JasonC0x0D/Hackster_Crew_2020_Public/Photos/Nozzle_Assembly.png

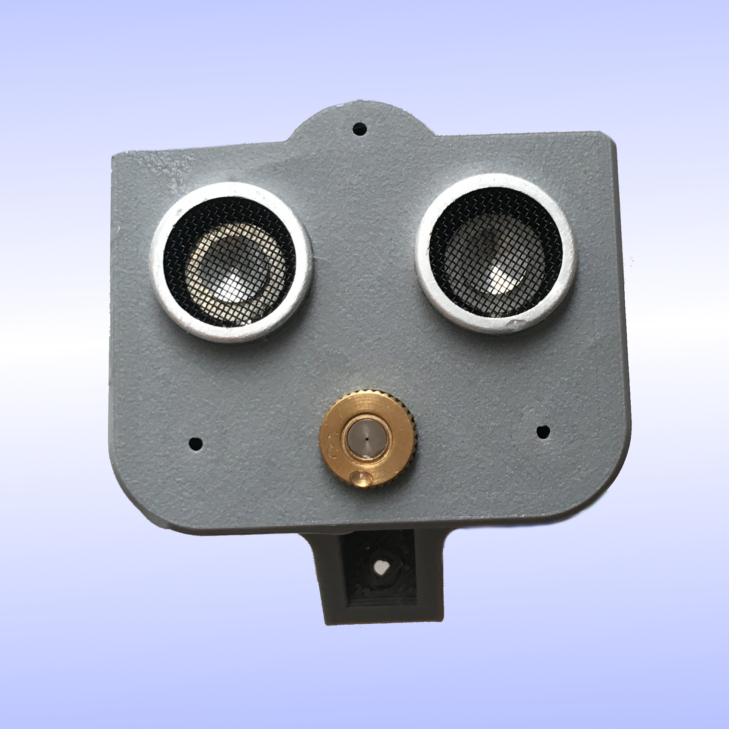
Photos/Nozzle_Assembly.png
