JasonC0x0D/Hackster_Crew_2020_Public/Photos/Assembly_isometric_front_gradient.png

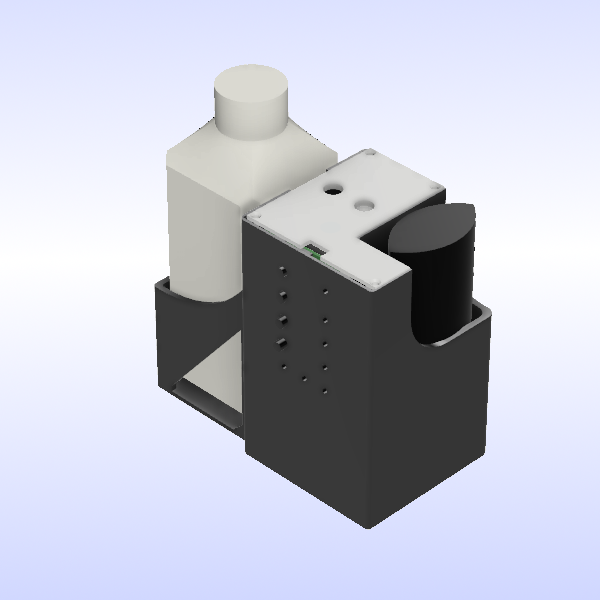
Photos/Assembly_isometric_front_gradient.png
