JasonC0x0D/Hackster_Crew_2020_Public/README.md

# Hackster_Crew_2020

Authors:
Chris Born
Forrest Carlson
Jason Cowin
Jordan Stanton
Blake Wiley

Project At:
https://www.hackster.io/hackster-crew-2020/sanitizer-2020-5bf8f2
