JasonC0x0D/Hackster_Crew_2020_Public/Photos/Features_gradient.png

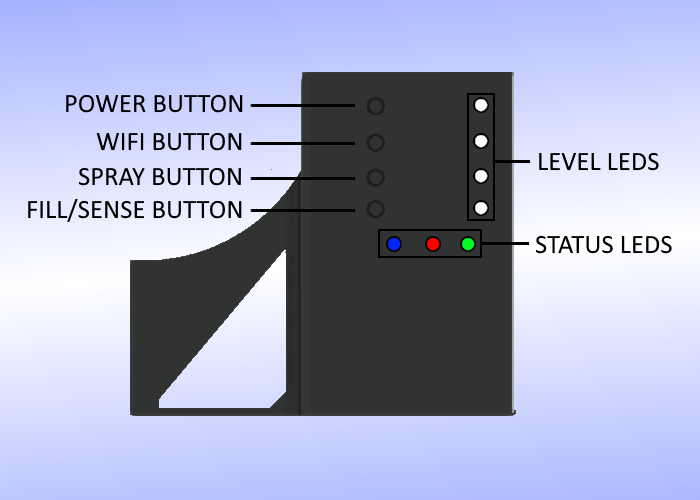
Photos/Features_gradient.png
