JasonC0x0D/Hackster_Crew_2020_Public/Photos/Features_no_background.png

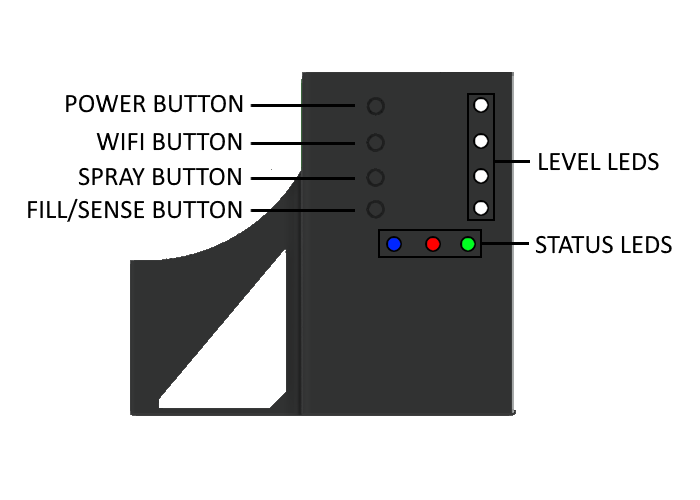
Photos/Features_no_background.png
