JasonC0x0D/Hackster_Crew_2020_Public/Photos/PCB_rendering.png

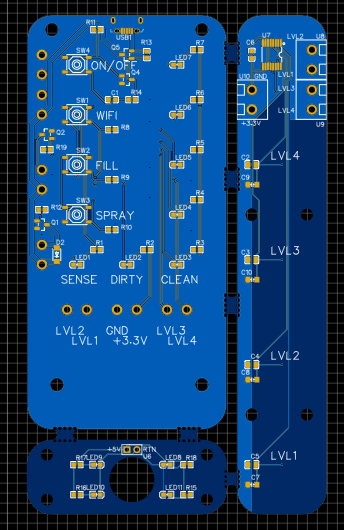
Photos/PCB_rendering.png
