JasonC0x0D/Hackster_Crew_2020_Public/Photos/Use_All.jpg

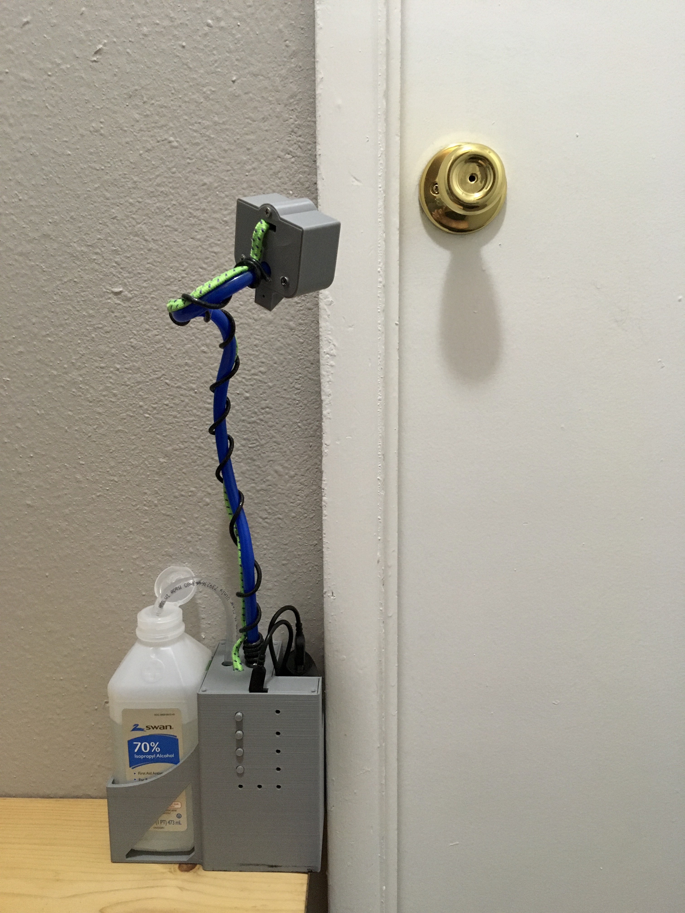
Photos/Use_All.jpg
