JasonC0x0D/Hackster_Crew_2020_Public/Photos/Use_Close_Up.jpg

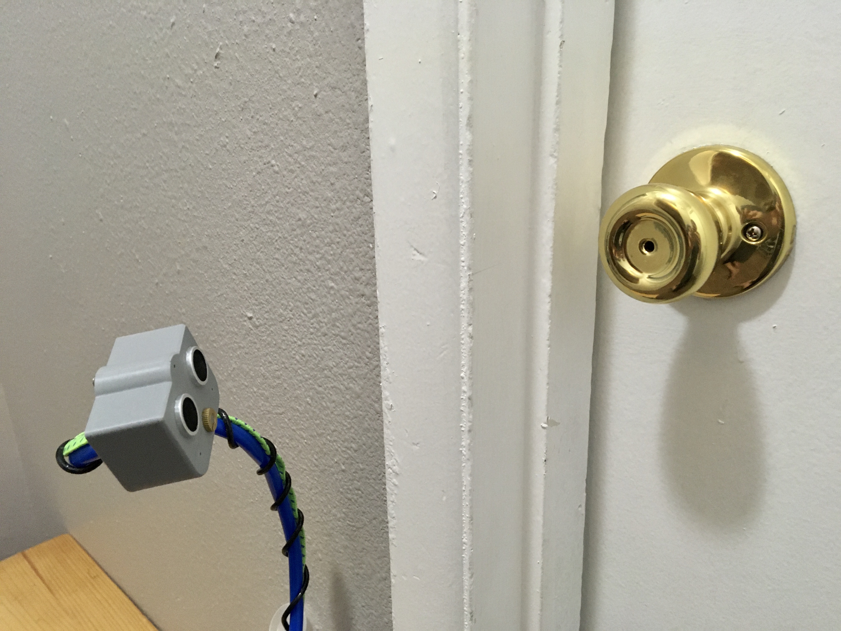
Photos/Use_Close_Up.jpg
