JasonC0x0D/Hackster_Crew_2020_Public/Schematics/State_Machine_Buttons.png

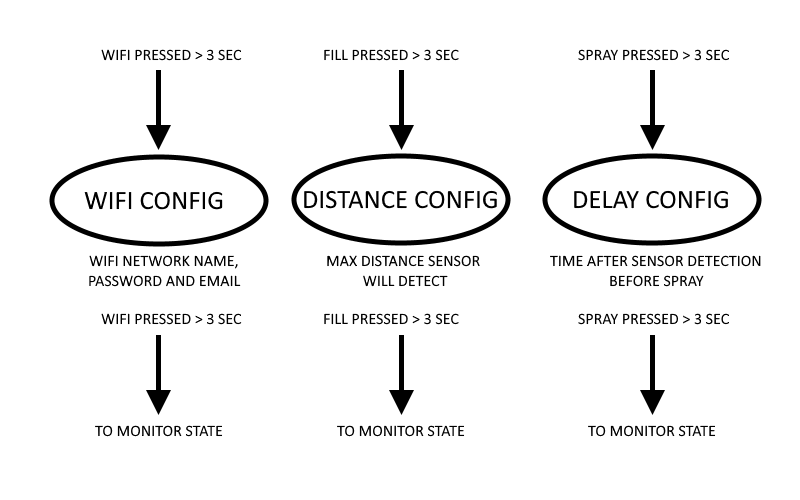
Schematics/State_Machine_Buttons.png
