JasonC0x0D/Hackster_Crew_2020_Public/Parts/BOM_Sterilizer 2020_2020-06-25_02-06-41.csv

ID | Name | Designator | Footprint | Quantity | Manufacturer Part | Manufacturer | Supplier | Supplier Part | LCSC Assembly
1 | 22pF | C2 | C0805 | 1 | CL21C220JBANNNC | SAMSUNG | LCSC | C1804 | Yes
2 | 100K | R14 | R0603 | 1 | 0603WAF1003T5E | UniOhm | LCSC | C25803 | Yes
3 | 6pF | C5 | C0805 | 1 | 0805CG6R0C500N | FH | LCSC | C67560 | Yes
4 | 33pF | C3 | C0805 | 1 | CL21C330JBANNNC | SAMSUNG | LCSC | C1814 | Yes
5 | PWR_ON/OFF_P_FET | Q5 | SOT-23_L2.9-W1.3-P0.95-LS2.4-BR | 1 | AO3401A | AOS | LCSC | C15127 | Yes
6 | DIRTY_RED | LED2 | LED0603-R-RD | 1 | 19-21/R7C-AN2Q1B/3T | Everlight Elec | LCSC | C40378 | Yes
7 | LEVEL_1_WHITE | LED4 | LED0603-R-RD | 1 | 19-21/R7C-AN2Q1B/3T | Everlight Elec | LCSC | C40378 | Yes
8 | LEVEL_2_WHITE | LED5 | LED0603-R-RD | 1 | 19-21/R7C-AN2Q1B/3T | Everlight Elec | LCSC | C40378 | Yes
9 | LEVEL_3_WHITE | LED6 | LED0603-R-RD | 1 | 19-21/R7C-AN2Q1B/3T | Everlight Elec | LCSC | C40378 | Yes
10 | LEVEL_4_WHITE | LED7 | LED0603-R-RD | 1 | 19-21/R7C-AN2Q1B/3T | Everlight Elec | LCSC | C40378 | Yes
11 | NOZ_1 | LED8,LED9,LED10,LED11 | LED0603-R-RD | 4 | 19-21/R7C-AN2Q1B/3T | Everlight Elec | LCSC | C40378 | Yes
12 | 100nF | C6 | C0603 | 1 | CC0603KRX7R9BB104 | YAGEO | LCSC | C14663 | Yes
13 | CLEAN_GREEN | LED3 | LED0603-R-RD | 1 | 19-217/GHC-YR1S2/3T | EVERLIGHT | LCSC | C72043 | Yes
14 | WIFI | SW1 | SW-SMD_4P-L5.1-W5.1-P3.70-LS6.4 | 1 | TS-1187A-B-A-B | XKB Enterprise | LCSC | C318884 | Yes
15 | FILL | SW2 | SW-SMD_4P-L5.1-W5.1-P3.70-LS6.4 | 1 | TS-1187A-B-A-B | XKB Enterprise | LCSC | C318884 | Yes
16 | SPRAY | SW3 | SW-SMD_4P-L5.1-W5.1-P3.70-LS6.4 | 1 | TS-1187A-B-A-B | XKB Enterprise | LCSC | C318884 | Yes
17 | PWR | SW4 | SW-SMD_4P-L5.1-W5.1-P3.70-LS6.4 | 1 | TS-1187A-B-A-B | XKB Enterprise | LCSC | C318884 | Yes
18 | Arduino_Nano_Every | U1 | ARDUINO_NANO_SMD | 1 | Arduino Nano V3
19 | 100 | R1,R3,R4,R5,R6,R7,R15,R16,R17,R18 | R0603 | 10 | 0603WAF1000T5E | UniOhm | LCSC | C22775 | Yes
20 | MICRO B | USB1 | MICRO-USB-SMD_10118194-0001LF | 1 | 10118194-0001LF | Amphenol ICC | LCSC | C132563
21 | 1uF | C1 | C0603 | 1 | CL10A105KB8NNNC | SAMSUNG | LCSC | C15849 | Yes
22 | SENSE_BLUE | LED1 | LED0603-R-RD | 1 | 19-217/BHC-ZL1M2RY/3T | EVERLIGHT | LCSC | C72041 | Yes
23 | PUMP | U2 | CONN-TH_2P-P5.00_L7.8-W10.0 | 1 | DB126V-5.0-2P | DIBO | LCSC | C395849
24 | SENSOR_2 | U3 | CONN-TH_2P-P5.00_L7.8-W10.0 | 1 | DB126V-5.0-2P | DIBO | LCSC | C395849
25 | SENSOR_1 | U4,U11,U12,U13,U8,U9,U10 | CONN-TH_2P-P5.00_L7.8-W10.0 | 7 | DB126V-5.0-2P | DIBO | LCSC | C395849
26 | MAIN_BOARD | U5 | CONN-TH_2P-P5.00_L7.8-W10.0 | 1 | DB126V-5.0-2P | DIBO | LCSC | C395849
27 | LED_RING | U6 | HDR-M-2.54_1X2 | 1 |  |  | LCSC | C124375
28 | 0 | C7,C8,C9,C10 | 0805-CAP-LARGEPADS | 4
29 | 10K | R13,R11,R12,R19 | R0603 | 4 | 0603WAF1002T5E | UniOhm | LCSC | C25804 | Yes
30 | 300 | R2,R8,R9,R10 | R0603 | 4 | 0603WAF3000T5E | UniOhm | LCSC | C23025 | Yes
31 | TTP224B-BSBN | U7 | TSSOP-16_L5.0-W4.4-P0.65-LS6.4-BL | 1 | TTP224B-BSBN | TONTEK | LCSC | C94149 | Yes
32 | 10pF | C4 | C0805 | 1 | CL21C100JBANNNC | SAMSUNG | LCSC | C1785 | Yes
33 | FLYBACK DIODE | D2 | SOD-123F_L2.8-W1.8-LS3.7-RD | 1 | SM4007PL | MDD | LCSC | C64898 | Yes
34 | PUMP_FET | Q1 | SOT-23-3_L2.9-W1.6-P1.90-LS2.8-BR | 1 | AO3400A | AOS | LCSC | C20917 | Yes
35 | PWR_ON/OFF_N_FET | Q4 | SOT-23-3_L2.9-W1.6-P1.90-LS2.8-BR | 1 | AO3400A | AOS | LCSC | C20917 | Yes
36 | LED_FET | Q2 | SOT-23-3_L2.9-W1.6-P1.90-LS2.8-BR | 1 | AO3400A | AOS | LCSC | C20917 | Yes
