JasonC0x0D/Hackster_Crew_2020_Public/(list of files, cad)

Other CAD files:
3D_Models/Alchohol(16FL OZ) v4.ipt
3D_Models/ButtonExtender v1.ipt
3D_Models/LargeBattery v2.ipt
3D_Models/LevelSensorPCB v1.ipt
3D_Models/MainAssembly.iam
3D_Models/MainHousing v4.ipt
3D_Models/MainHousingLid v37.ipt
3D_Models/MainPCB v1.ipt
3D_Models/Pump v2.ipt
