JasonC0x0D/Hackster_Crew_2020_Public/Schematics/Schematic_Sterilizer 2020_2020-06-21_20-05-39.pdf

# B1 B1 B2 B2 B3 B3 B4 B4 B5 B5 B6 B6 B7 B7 B8 B8 B9 B9 B10 B10 B11 B11 B12 B12

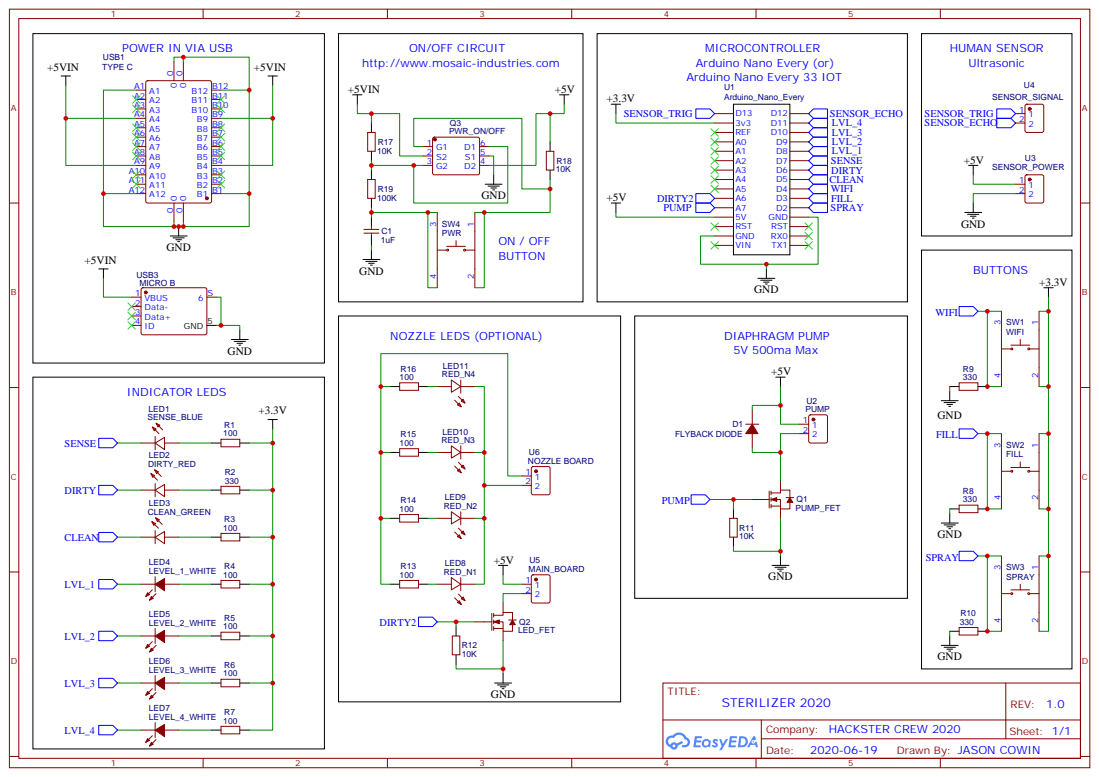
[picture p11: page 1]

MICROCONTROLLER
Arduino Nano Every (or)
Arduino Nano Every 33 IOT

http://www.mosaic-industries.com

Drawn By: JASON COWIN
