JasonC0x0D/Hackster_Crew_2020_Public/(list of files, drawings)

Other design files:
Schematics/PCB_Layout_2020-08-30_20-17-49.json
