JasonC0x0D/Hackster_Crew_2020_Public/Photos/Assembly_exploded_gradient.png

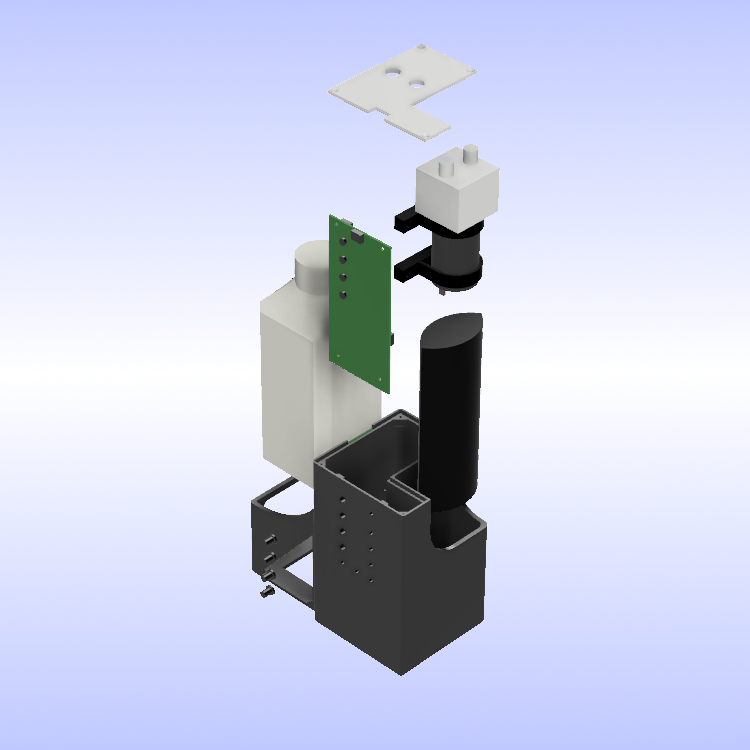
Photos/Assembly_exploded_gradient.png
