JasonC0x0D/Hackster_Crew_2020_Public/Photos/PCB_Raw_Front.JPG

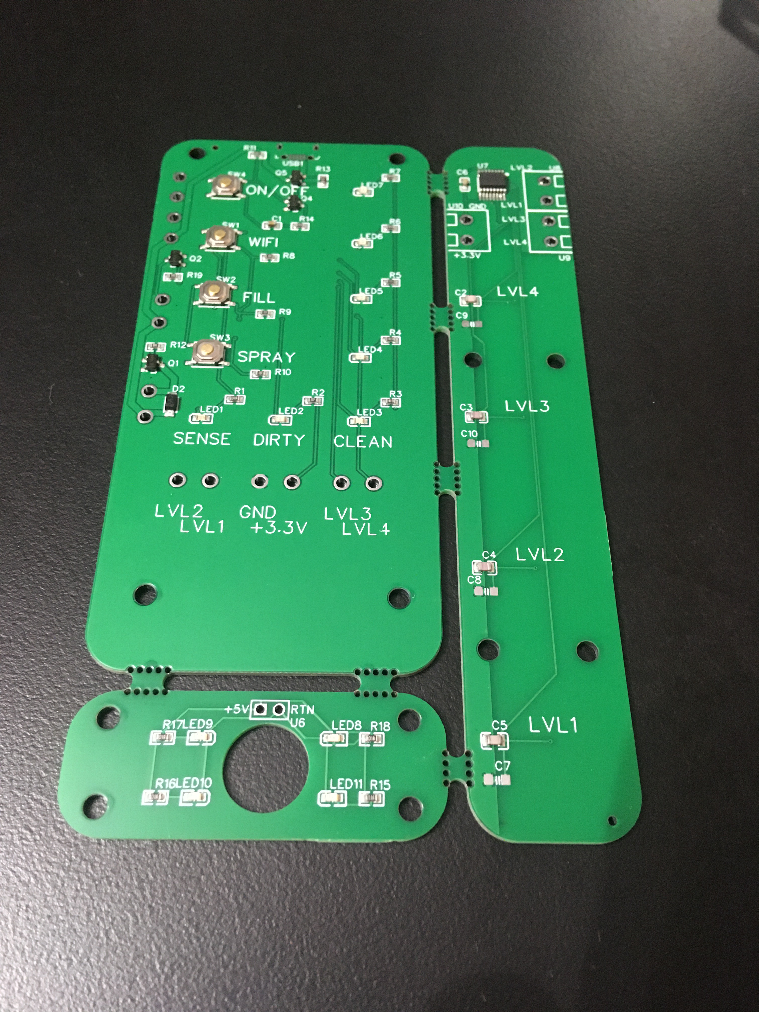
Photos/PCB_Raw_Front.JPG
